ProfeRimoldi/Reloj-Digital-con-ESP32/KiCad/Reloj 3 Placas/.step

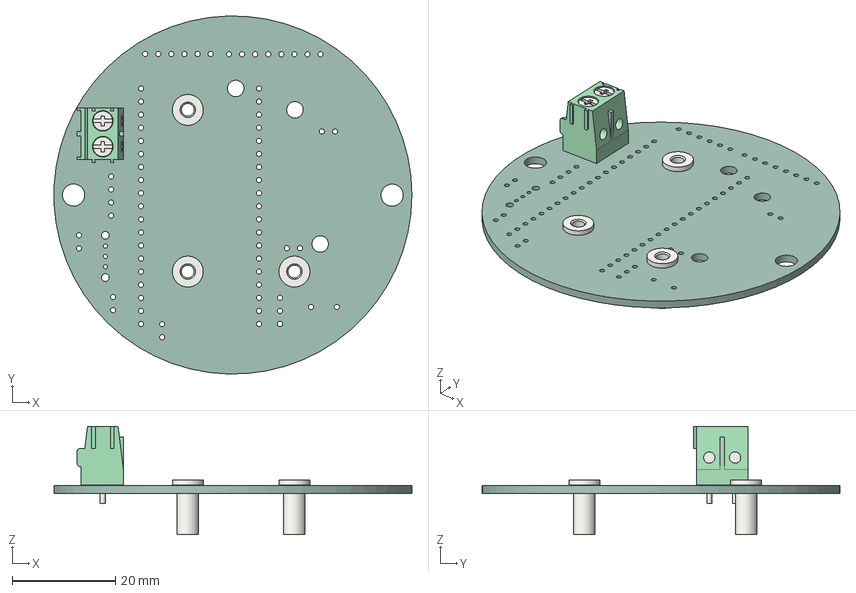
[picture p3: CAD file, 2026-10-23]
KiCad/Reloj 3 Placas/.step
69.5 x 69.5 x 21.0 mm
Mounting_Wuerth_WA-SMSR-M3_H9.6mm_ReverseMount_9775096360 x 3
TerminalBlock_Phoenix_PT-1,5-2-5.0-H_1x02_P5.00mm_Horizontal
OBC_PCB
