ProfeRimoldi/Reloj-Digital-con-ESP32/Outputs/Reloj 3 Placas.pdf

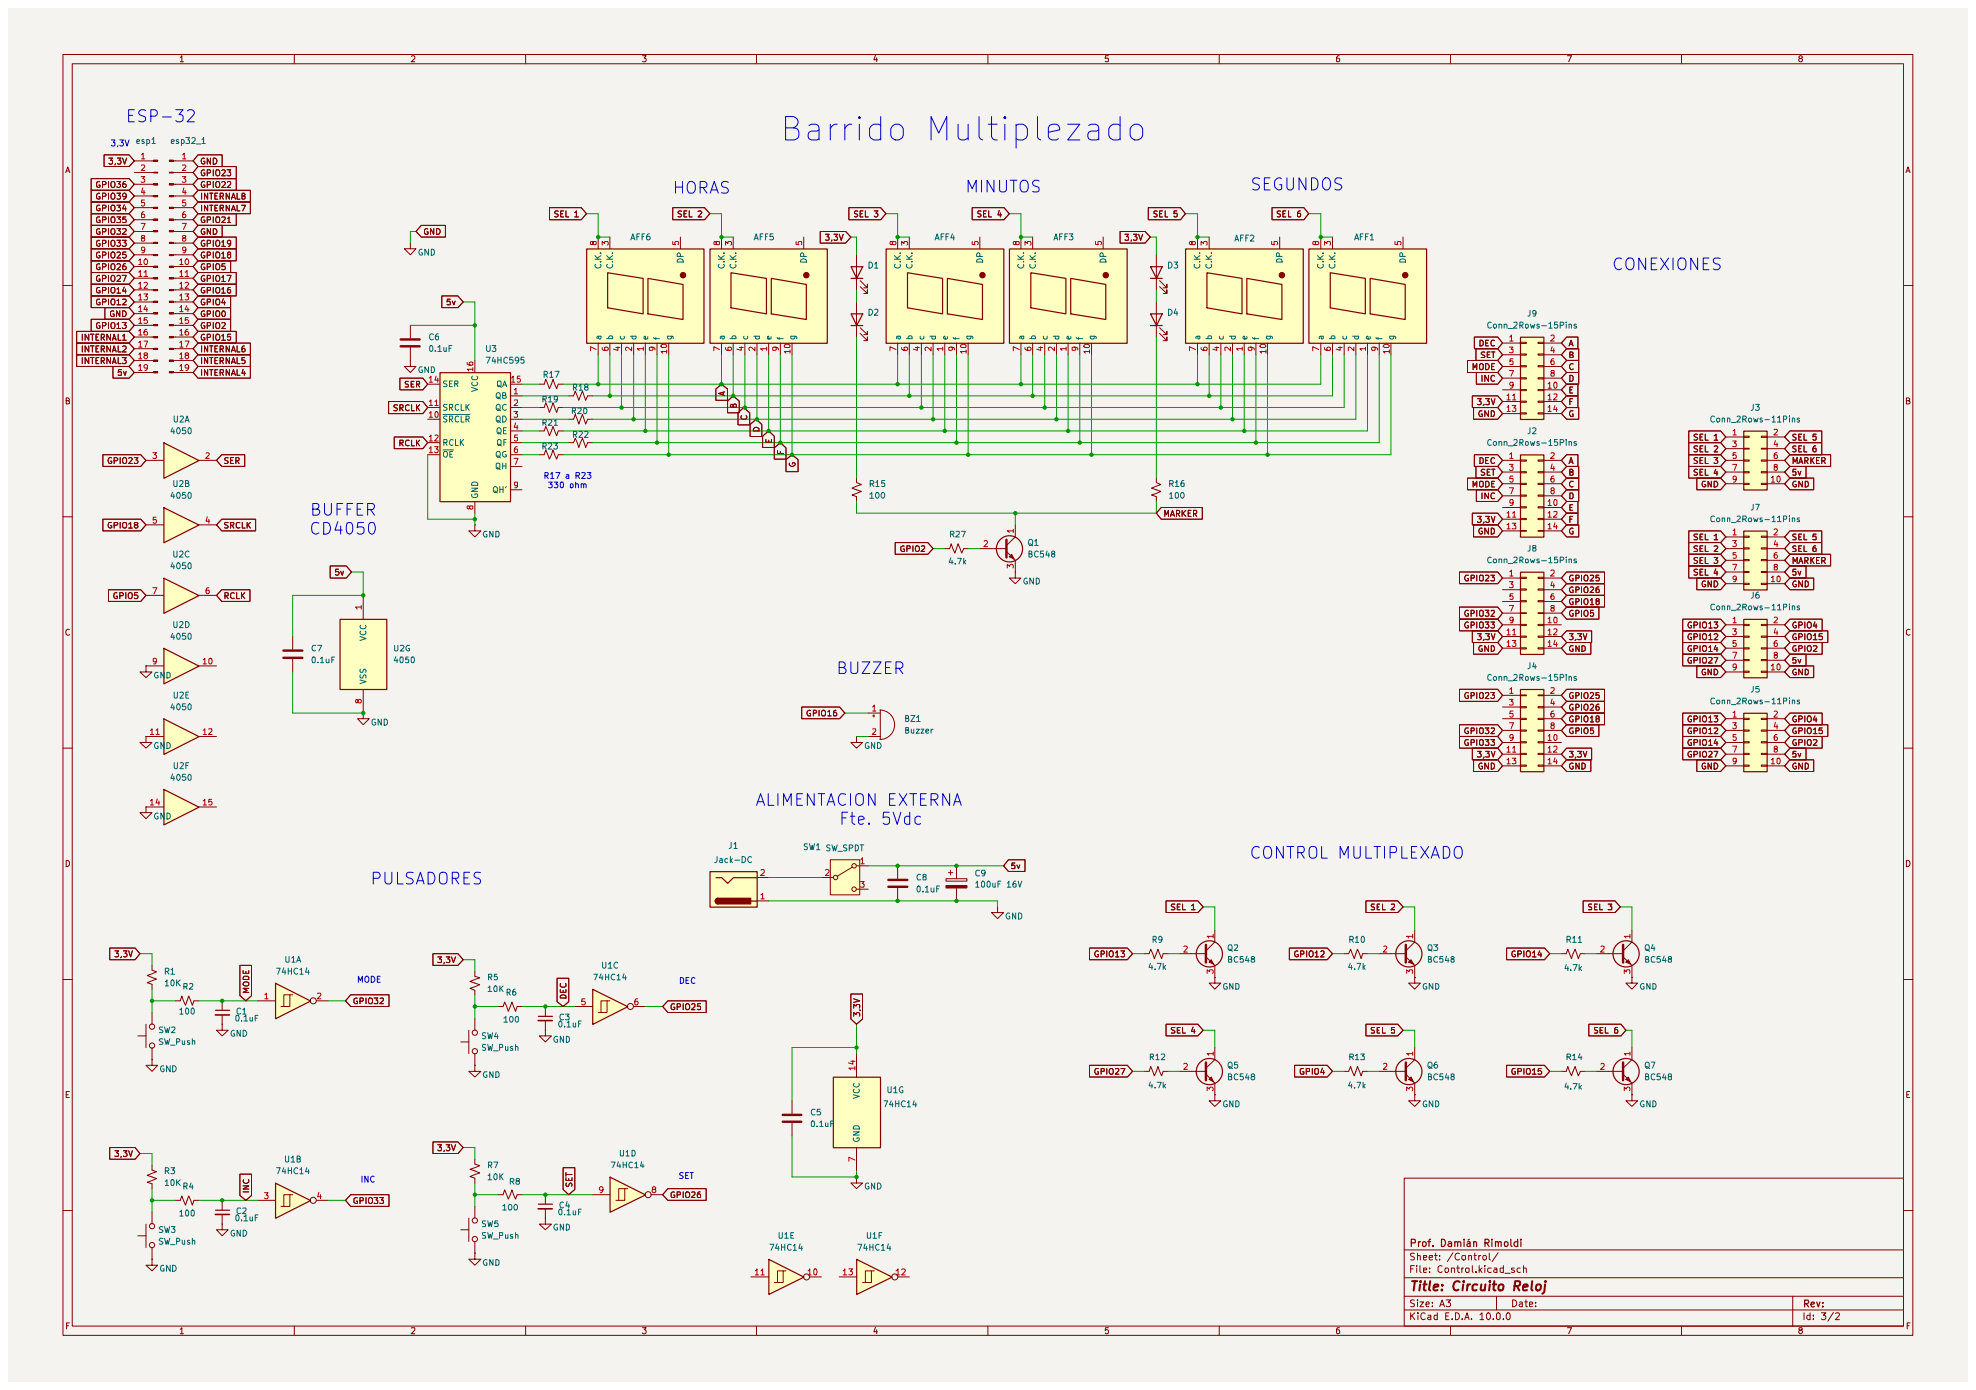
[picture p4: page 1]
