ProfeRimoldi/Reloj-Digital-con-ESP32/Outputs/1 Bcu.pdf

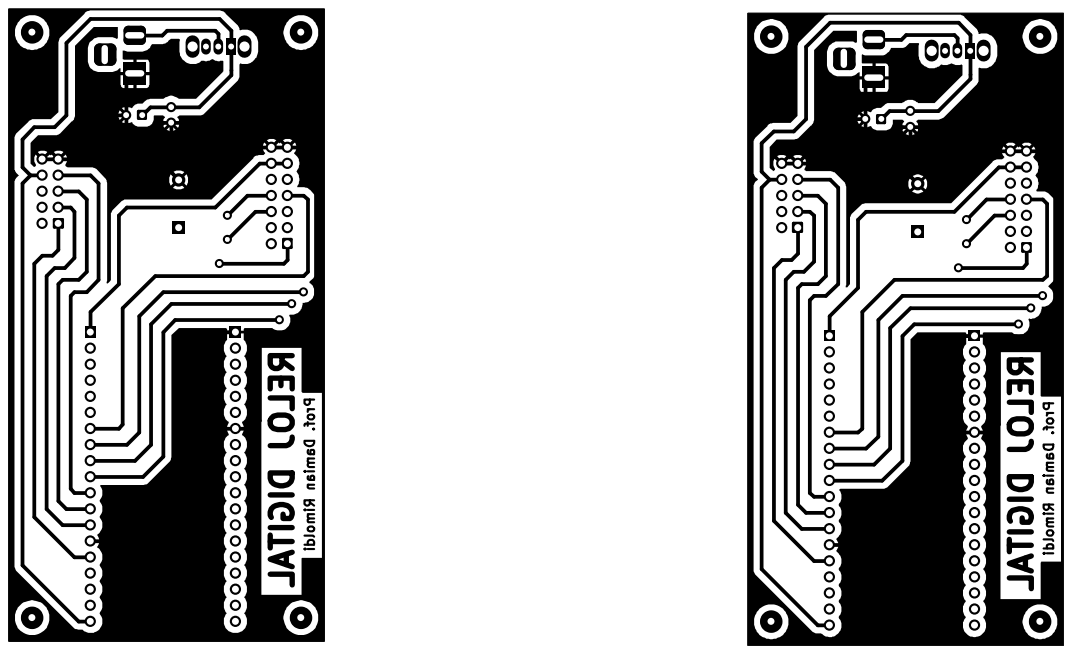
[picture p5: page 1]
