ProfeRimoldi/Reloj-Digital-con-ESP32/Outputs/1 Fcu.pdf

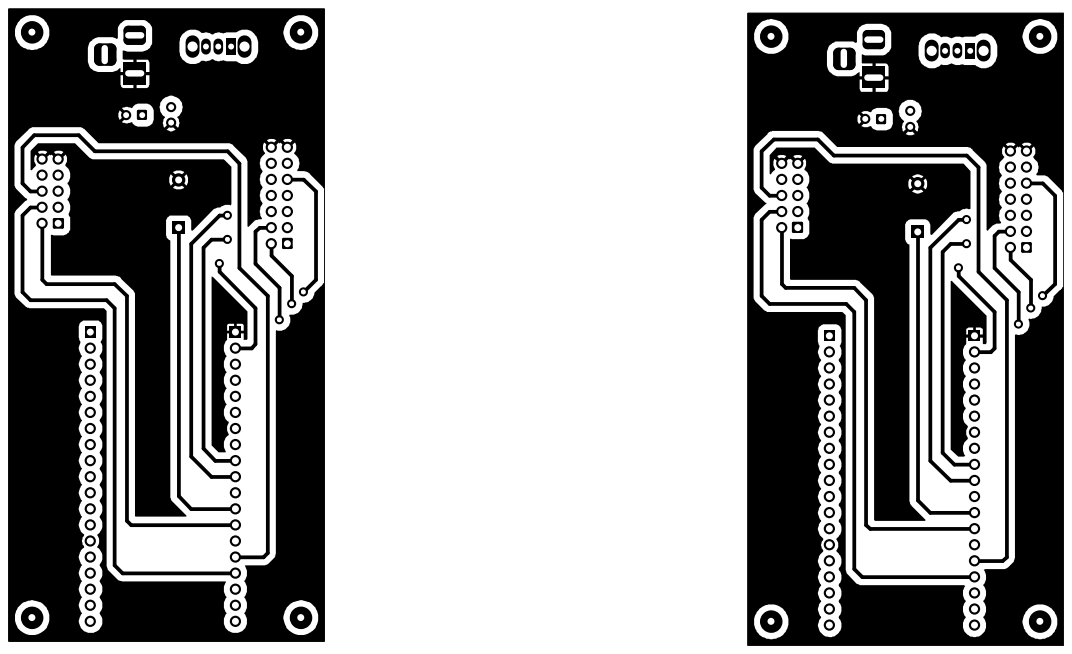
[picture p6: page 1]
