ProfeRimoldi/Reloj-Digital-con-ESP32/Outputs/2 Bcu.pdf

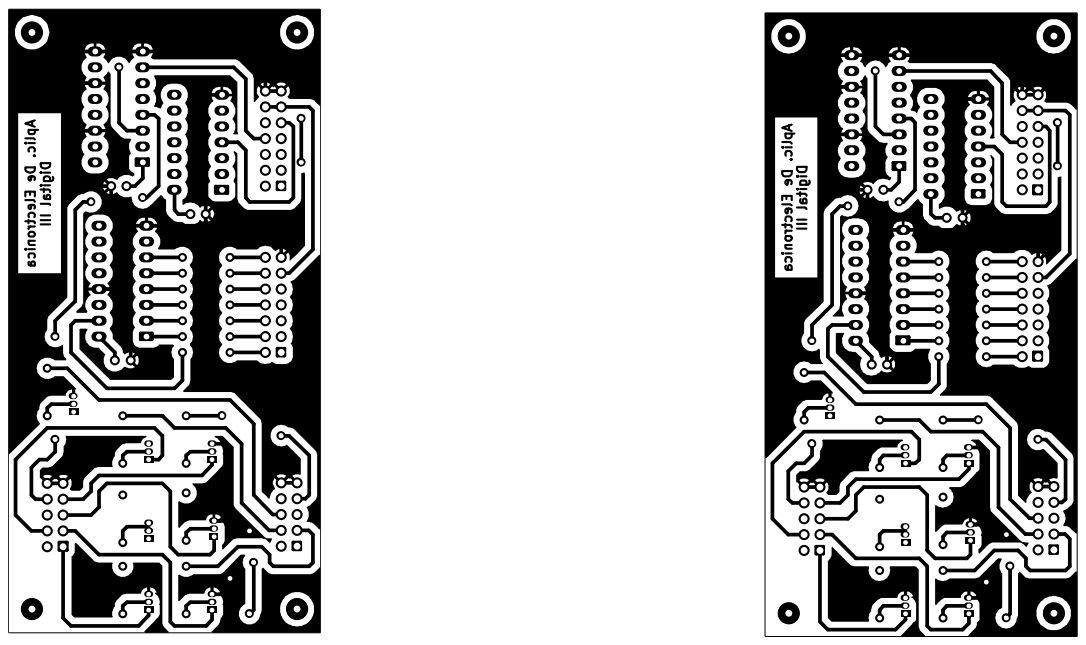
[picture p7: page 1]
