ProfeRimoldi/Reloj-Digital-con-ESP32/Outputs/2 Fcu.pdf

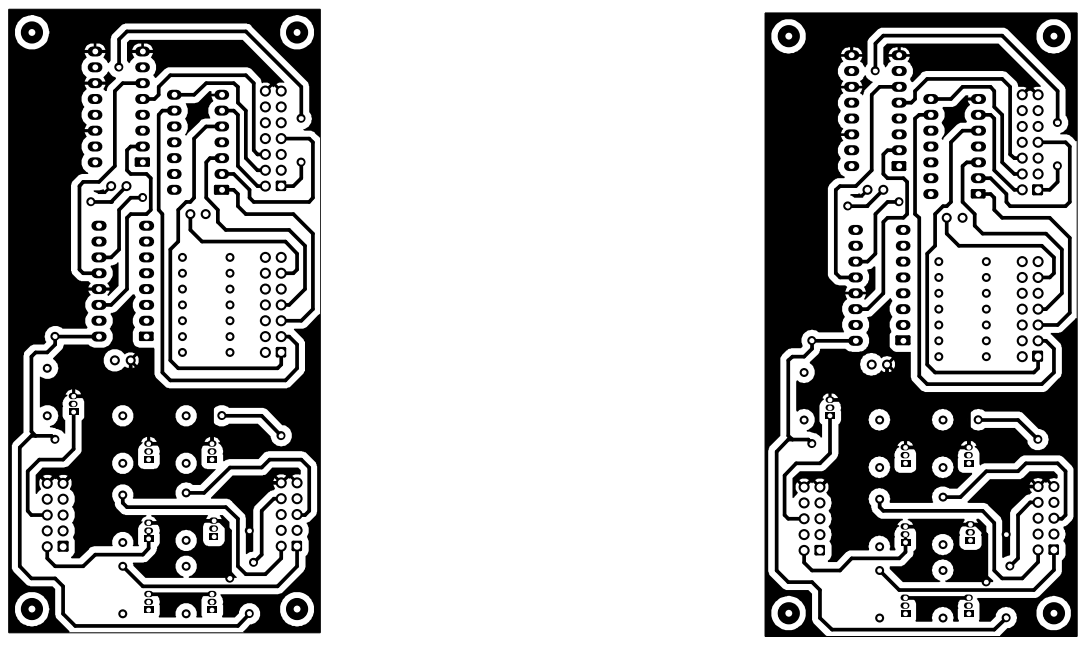
[picture p8: page 1]
