ProfeRimoldi/Reloj-Digital-con-ESP32/Outputs/3 Bcu.pdf

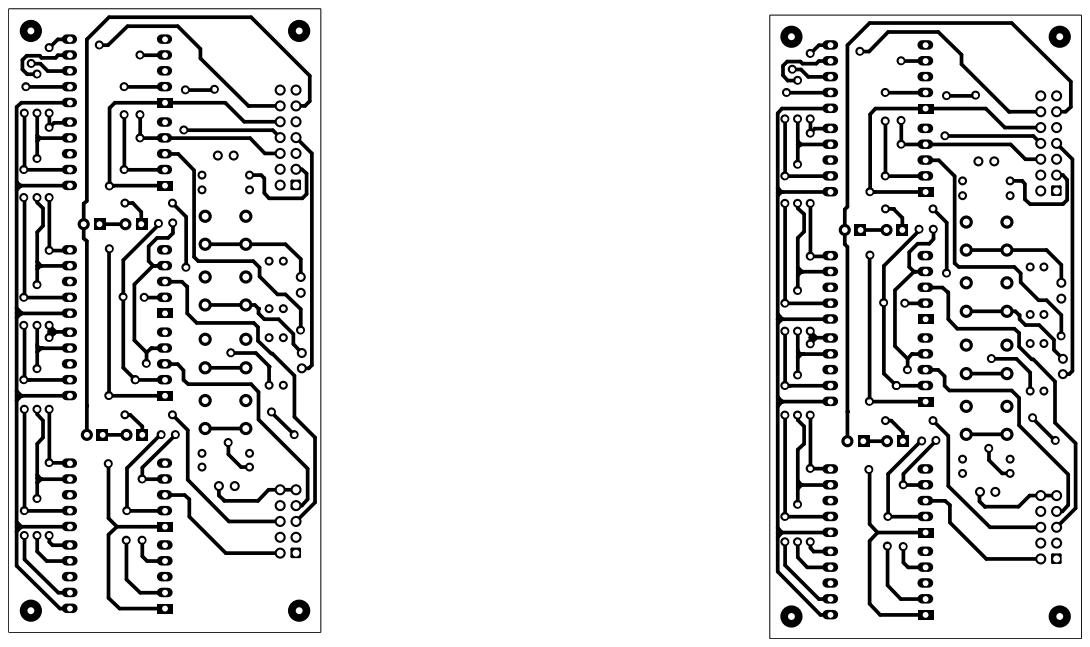
[picture p9: page 1]
