ProfeRimoldi/Reloj-Digital-con-ESP32/Outputs/3 Fcu.pdf

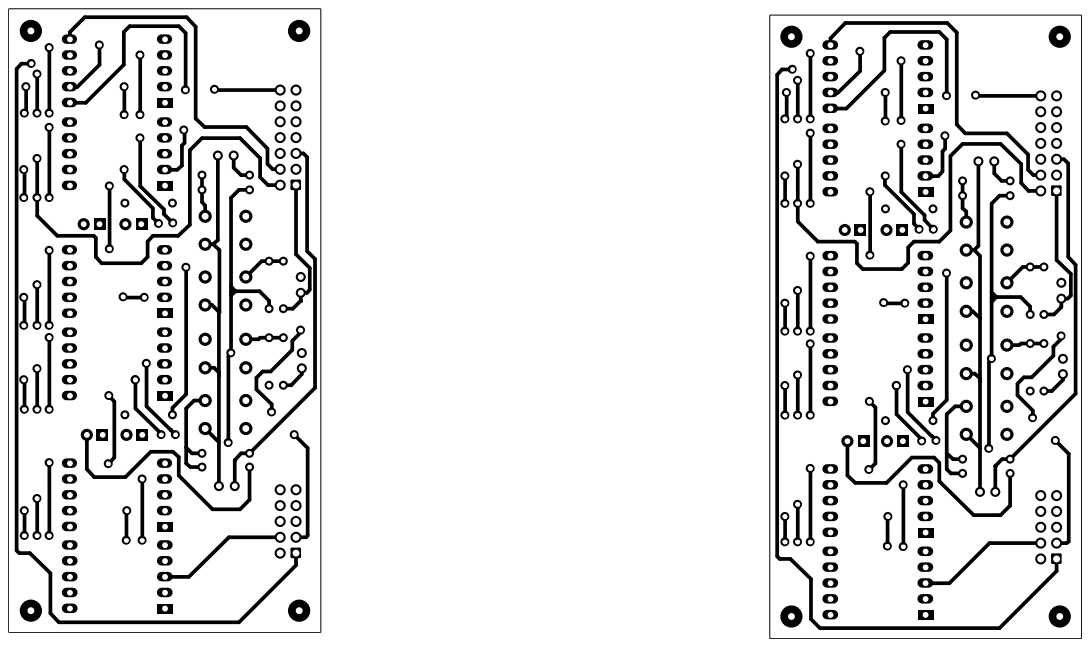
[picture p10: page 1]
