ProfeRimoldi/Reloj-Digital-con-ESP32/KiCad/1.pdf

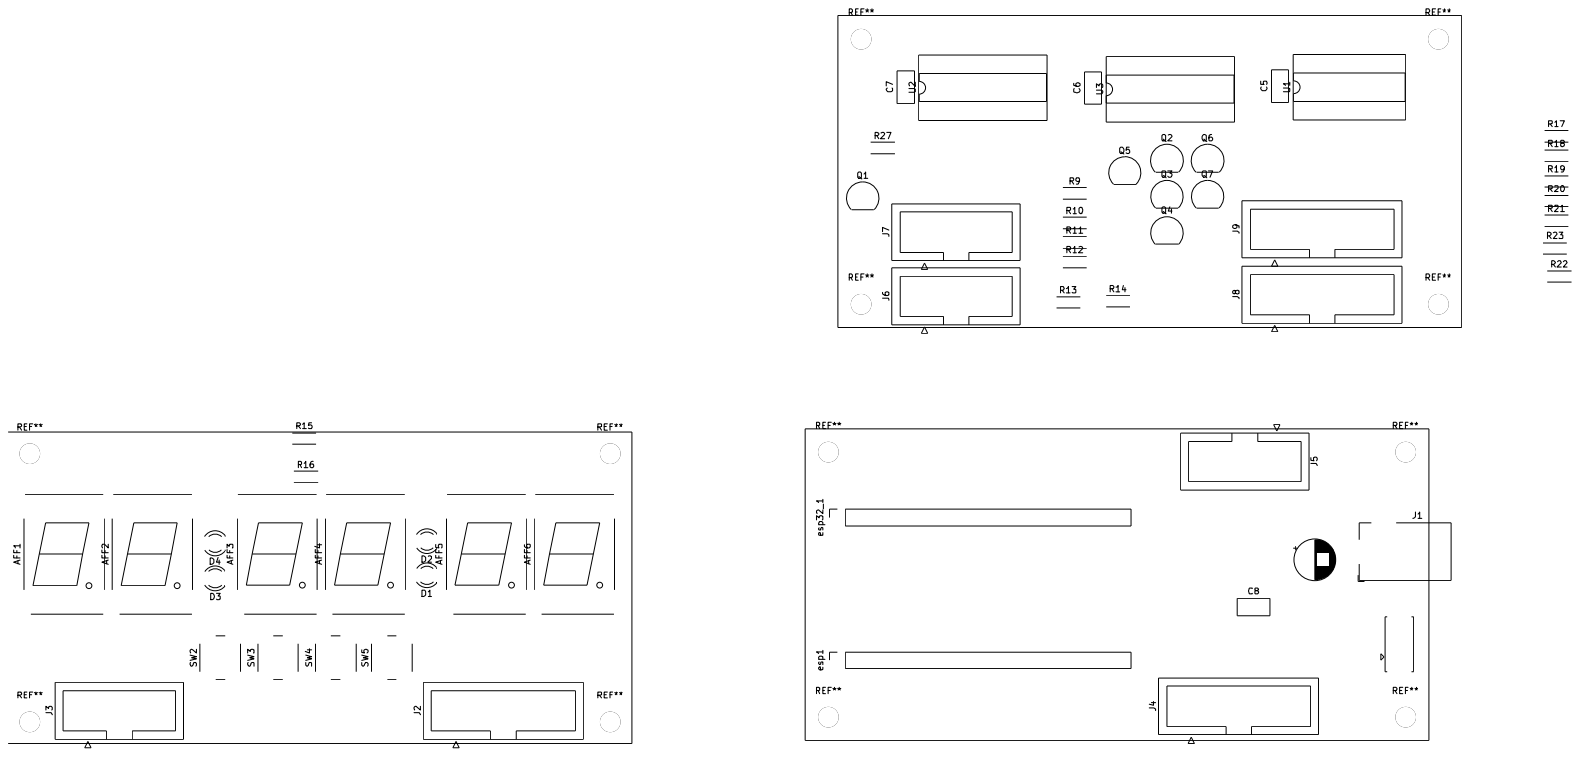
[picture p11: page 1]
