ProfeRimoldi/Reloj-Digital-con-ESP32/KiCad/2.pdf

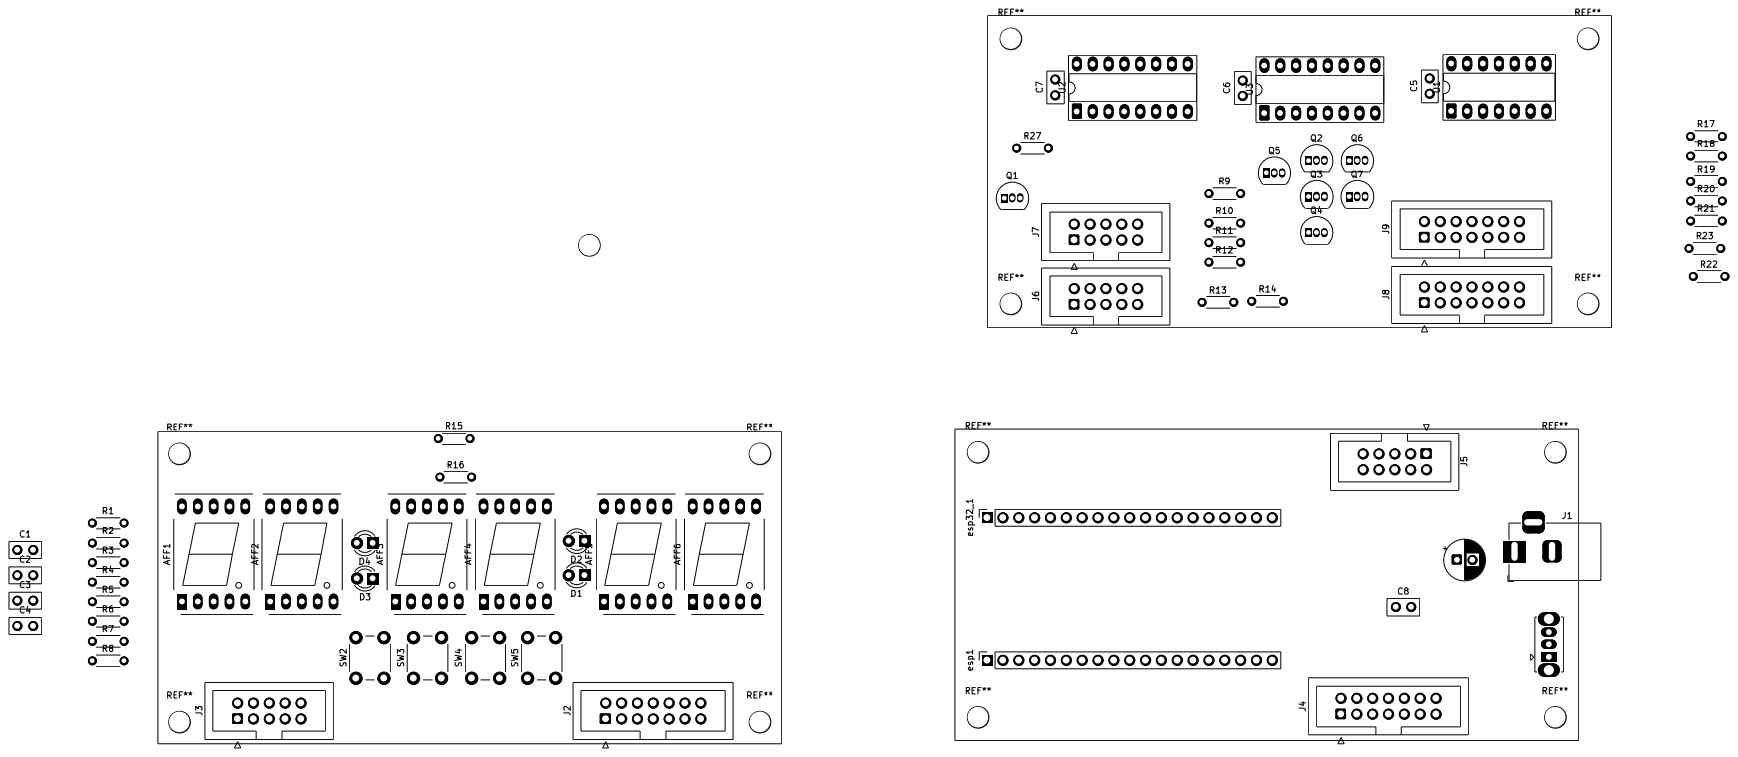
[picture p12: page 1]
