ProfeRimoldi/Reloj-Digital-con-ESP32/Documentacion general/Circuito Reloj con 74HC595.pdf

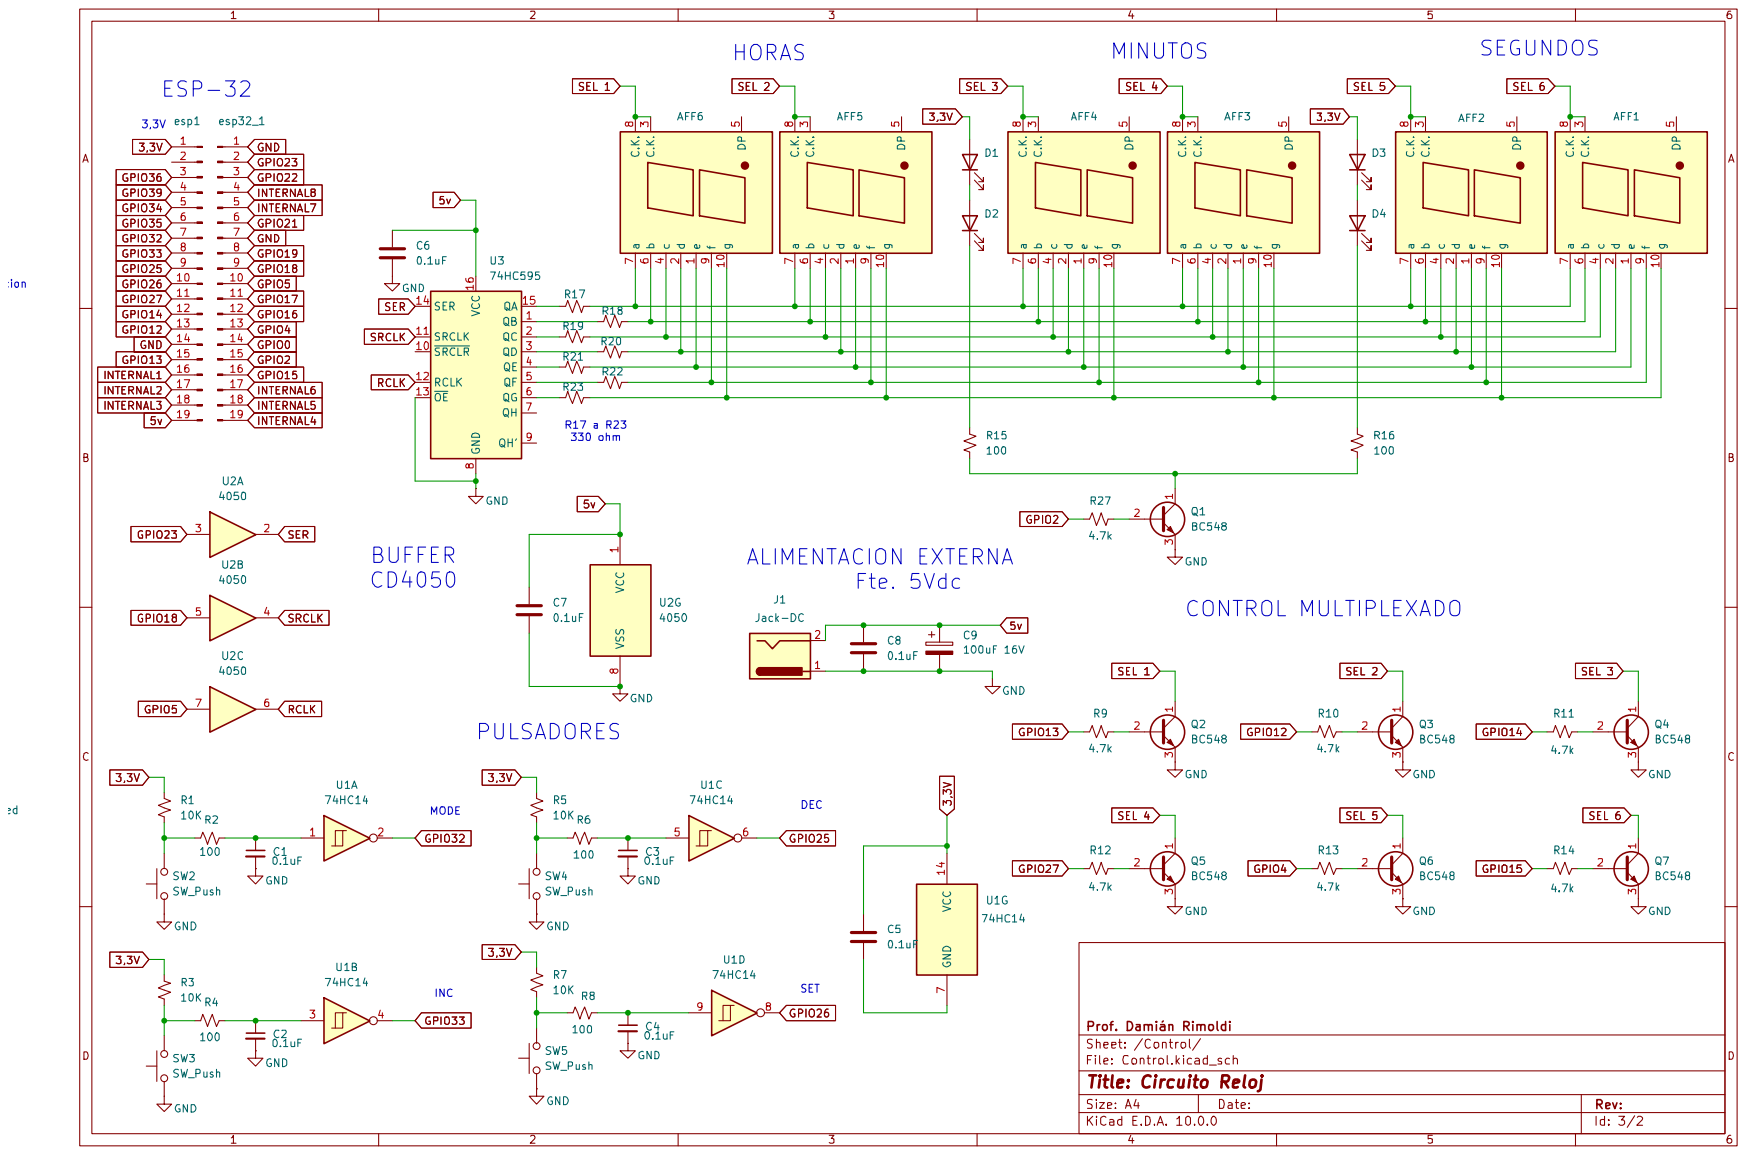
[picture p13: page 1]
