ProfeRimoldi/Reloj-Digital-con-ESP32/Documentacion general/Circuito Reloj.pdf

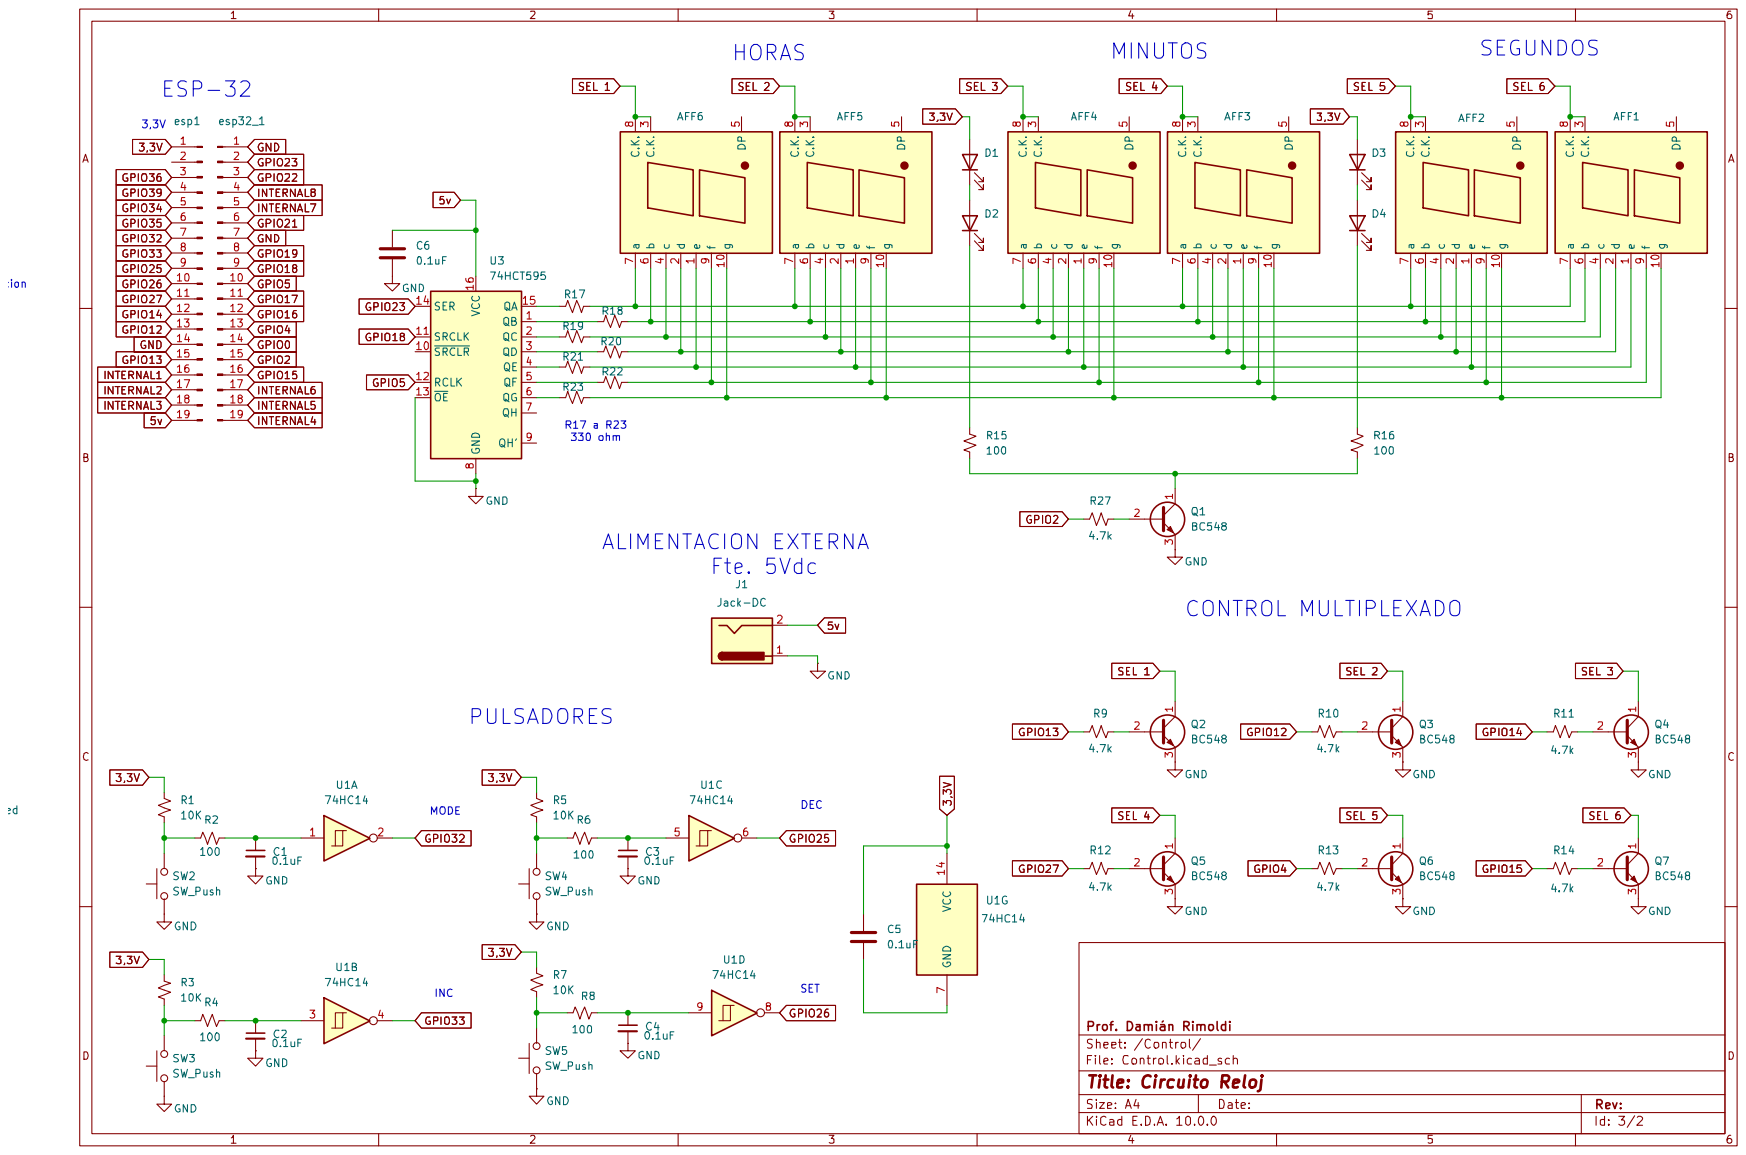
[picture p14: page 1]
