ProfeRimoldi/Reloj-Digital-con-ESP32/Outputs/Fcu/1 Fcu.pdf

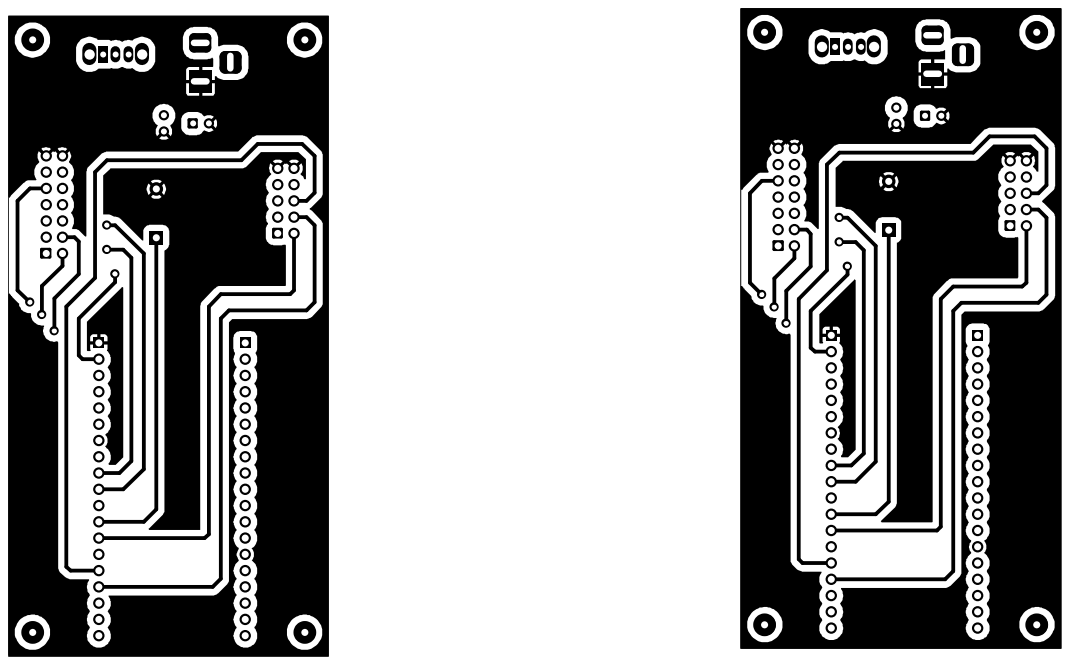
[picture p15: page 1]
