ProfeRimoldi/Reloj-Digital-con-ESP32/Outputs/Fcu/2 Fcu.pdf

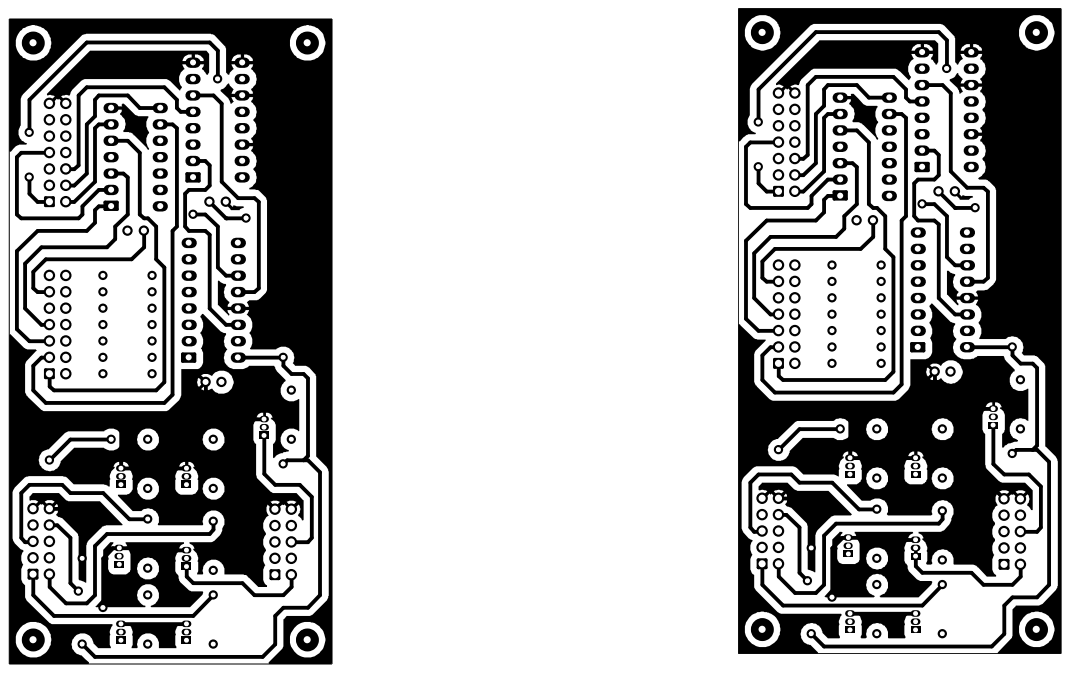
[picture p16: page 1]
