ProfeRimoldi/Reloj-Digital-con-ESP32/Outputs/Fcu/3 Fcu.pdf

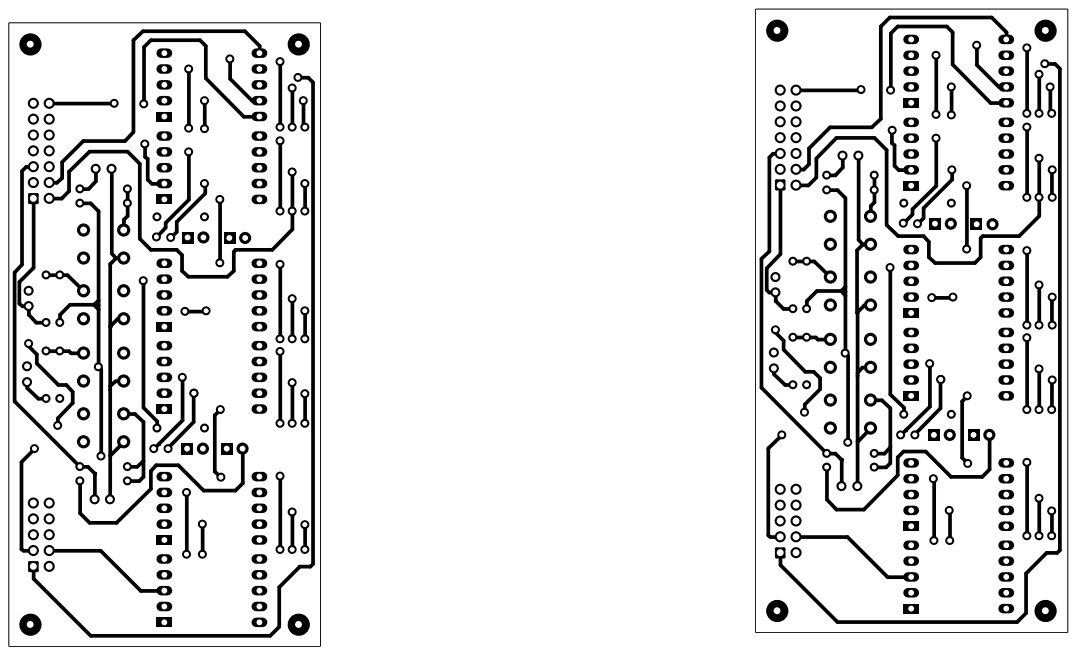
[picture p17: page 1]
