ProfeRimoldi/Reloj-Digital-con-ESP32/KiCad/Reloj/Reloj.kicad_pcb

## KiCad design KiCad/Reloj/Reloj.kicad_pcb (2026-11-04)

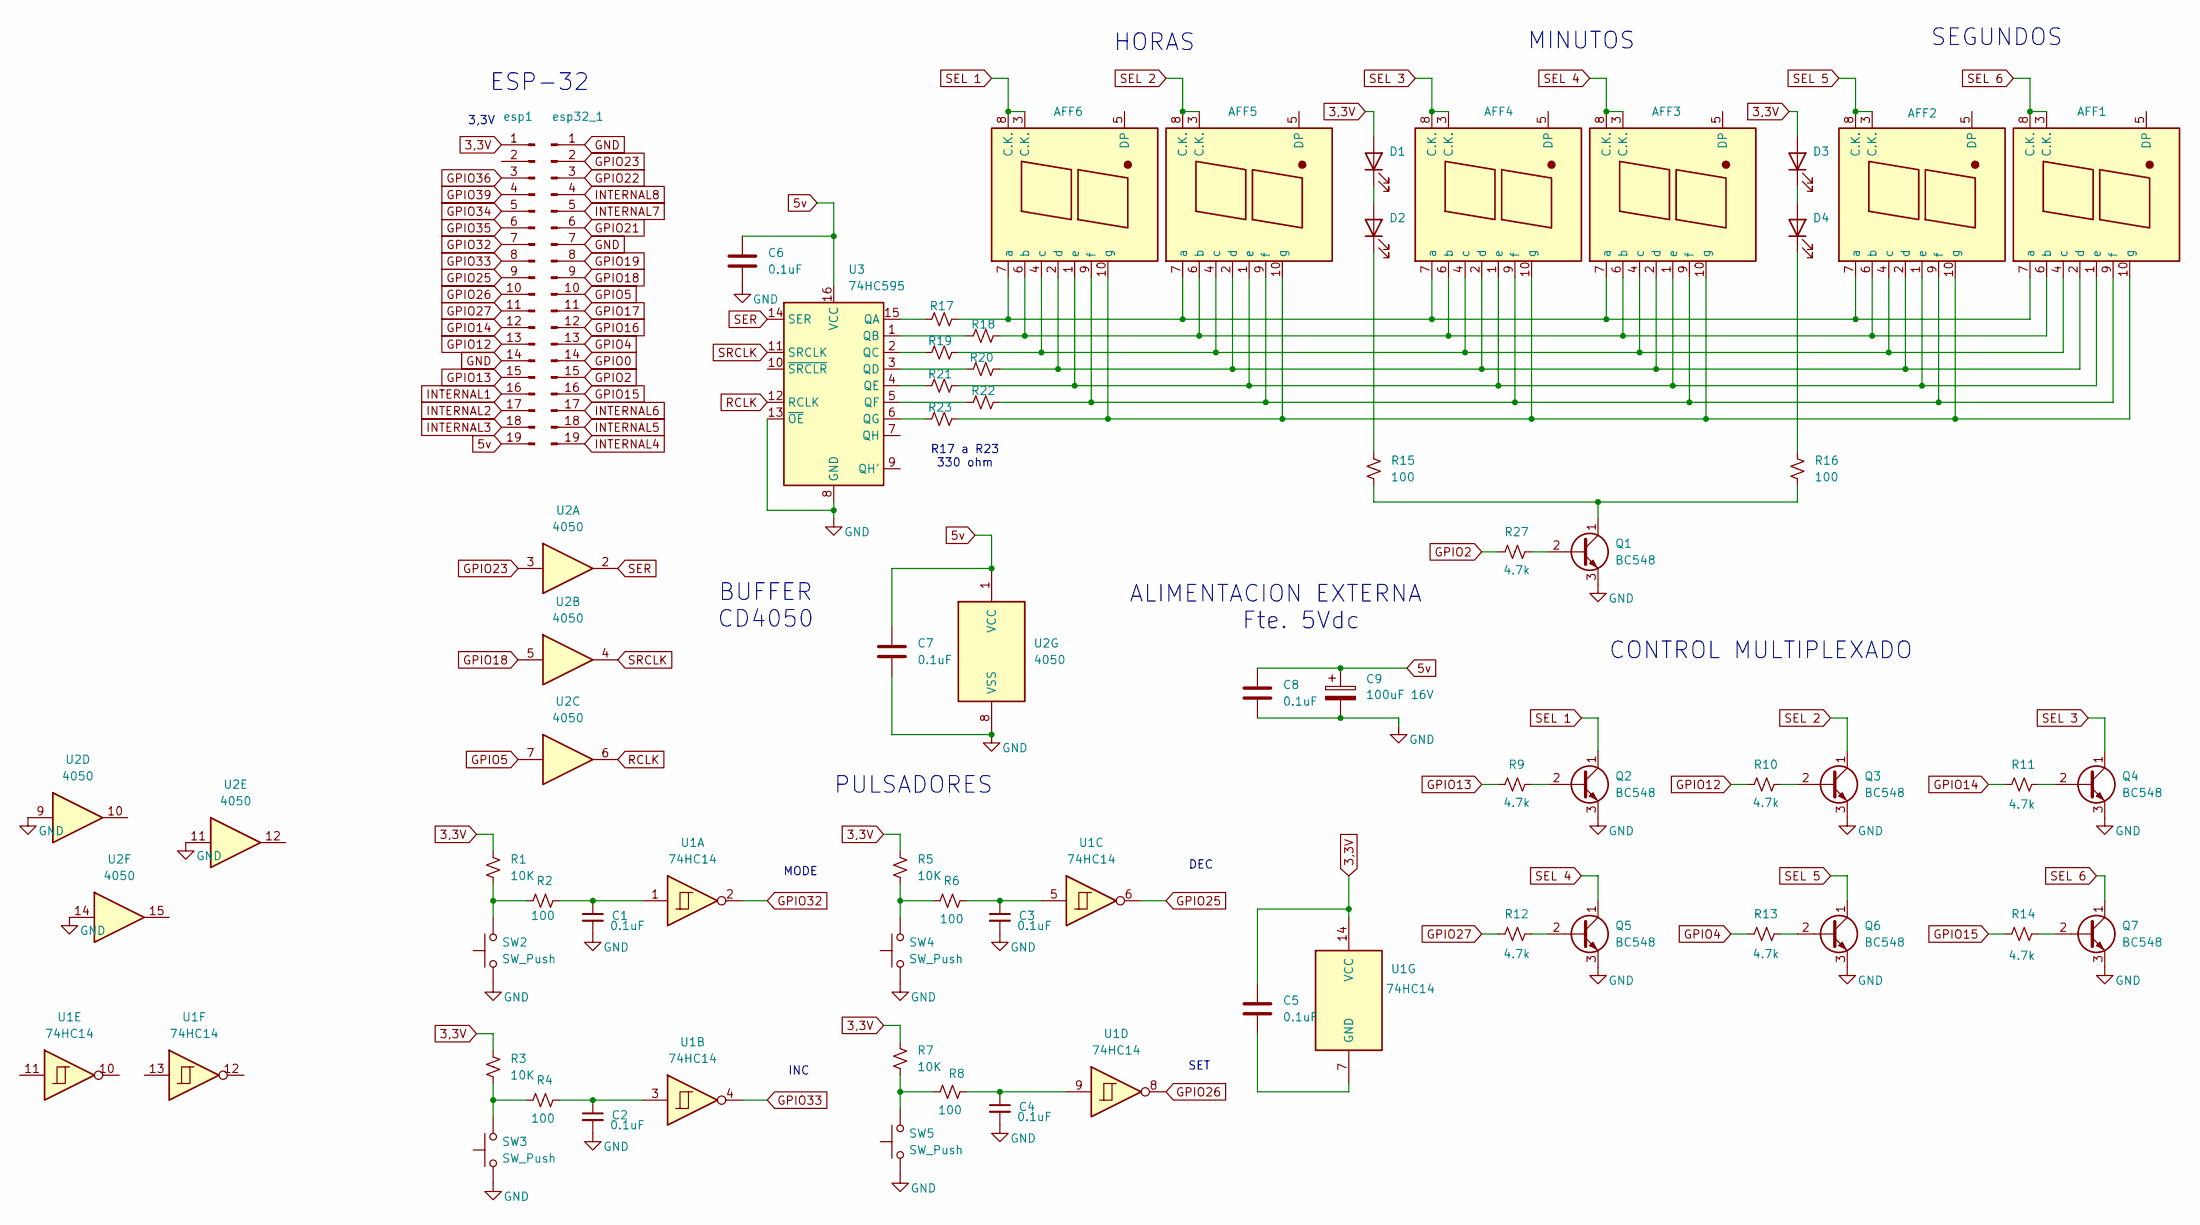
[picture p18: schematic Control.kicad_sch, Circuito Reloj]

Parts:
AFF1, AFF2, AFF3, AFF4, AFF5, AFF6: LTS-6980HR; 7SegmentLED_LTS6760_LTS6780
C1, C2, C3, C4, C5, C6, C7, C8: 0.1uF; C_Disc_D5.0mm_W2.5mm_P2.50mm
C9: 100uF 16V; CP_Radial_D6.3mm_P2.50mm
D1, D2, D3, D4: LED; LED_D3.0mm
Q1, Q2, Q3, Q4, Q5, Q6, Q7: BC548; TO-92_Inline
R1, R3, R5, R7: 10K; R_Axial_DIN0204_L3.6mm_D1.6mm_P5.08mm_Horizontal
R2, R4, R6, R8, R15, R16: 100; R_Axial_DIN0204_L3.6mm_D1.6mm_P5.08mm_Horizontal
R9, R10, R11, R12, R13, R14, R27: 4.7k; R_Axial_DIN0204_L3.6mm_D1.6mm_P5.08mm_Horizontal
R17, R18, R19, R20, R21, R22, R23: 330; R_Axial_DIN0204_L3.6mm_D1.6mm_P5.08mm_Horizontal
SW2, SW3, SW4, SW5: SW_Push; SW_PUSH_6mm_H4.3mm
U1: 74HC14; DIP-14_W7.62mm_Socket_LongPads
U2: 4050; DIP-16_W7.62mm_Socket_LongPads
U3: 74HC595; DIP-16_W7.62mm_Socket_LongPads
esp1, esp32_1: Conn_01x19_Pin; PinSocket_1x19_P2.54mm_Vertical

Connections:
3,3V: C5.1, D1.2 (A), D3.2 (A), R1.1, R3.1, R5.1, R7.1, U1.14 (VCC), esp1.1
5v: C6.1, C7.1, C8.1, C9.1, U2.1 (VCC), U3.16 (VCC), esp1.19
GND: C1.2, C2.2, C3.2, C4.2, C6.2, C7.2, C8.2, C9.2, Q1.3 (E), Q2.3 (E), Q3.3 (E), Q4.3 (E), Q5.3 (E), Q6.3 (E), Q7.3 (E), SW2.1, SW3.1, SW4.1, SW5.1, U2.8 (VSS), U2.9, U2.11, U2.14, U3.8 (GND), U3.13 (~OE), esp1.14, esp32_1.1, esp32_1.7
GPIO0: esp32_1.14
GPIO2: R27.2, esp32_1.15
GPIO4: R13.2, esp32_1.13
GPIO5: U2.7, esp32_1.10
GPIO12: R10.2, esp1.13
GPIO13: R9.2, esp1.15
GPIO14: R11.2, esp1.12
GPIO15: R14.2, esp32_1.16
GPIO16: esp32_1.12
GPIO17: esp32_1.11
GPIO18: U2.5, esp32_1.9
GPIO19: esp32_1.8
GPIO21: esp32_1.6
GPIO22: esp32_1.3
GPIO23: U2.3, esp32_1.2
GPIO25: U1.6, esp1.9
GPIO26: U1.8, esp1.10
GPIO27: R12.2, esp1.11
GPIO32: U1.2, esp1.7
GPIO33: U1.4, esp1.8
GPIO34: esp1.5
GPIO35: esp1.6
GPIO36: esp1.3
GPIO39: esp1.4
INTERNAL1: esp1.16
INTERNAL2: esp1.17
INTERNAL3: esp1.18
INTERNAL4: esp32_1.19
INTERNAL5: esp32_1.18
INTERNAL6: esp32_1.17
INTERNAL7: esp32_1.5
INTERNAL8: esp32_1.4
unnamed: AFF1.7 (a), AFF2.7 (a), AFF3.7 (a), AFF4.7 (a), AFF5.7 (a), AFF6.7 (a), R17.1
unnamed: AFF1.6 (b), AFF2.6 (b), AFF3.6 (b), AFF4.6 (b), AFF5.6 (b), AFF6.6 (b), R18.1
unnamed: AFF1.4 (c), AFF2.4 (c), AFF3.4 (c), AFF4.4 (c), AFF5.4 (c), AFF6.4 (c), R19.1
unnamed: AFF1.2 (d), AFF2.2 (d), AFF3.2 (d), AFF4.2 (d), AFF5.2 (d), AFF6.2 (d), R20.1
unnamed: AFF1.1 (e), AFF2.1 (e), AFF3.1 (e), AFF4.1 (e), AFF5.1 (e), AFF6.1 (e), R21.1
unnamed: AFF1.9 (f), AFF2.9 (f), AFF3.9 (f), AFF4.9 (f), AFF5.9 (f), AFF6.9 (f), R22.1
unnamed: AFF1.10 (g), AFF2.10 (g), AFF3.10 (g), AFF4.10 (g), AFF5.10 (g), AFF6.10 (g), R23.1
unnamed: C1.1, R2.1, U1.1
unnamed: C2.1, R4.1, U1.3
unnamed: C3.1, R6.1, U1.5
unnamed: C4.1, R8.1, U1.9
unnamed: D1.1 (K), D2.2 (A)
unnamed: D2.1 (K), R15.1
unnamed: D3.1 (K), D4.2 (A)
unnamed: D4.1 (K), R16.1
unnamed: Q1.2 (B), R27.1
unnamed: Q1.1 (C), R15.2, R16.2
unnamed: Q2.2 (B), R9.1
unnamed: Q3.2 (B), R10.1
unnamed: Q4.2 (B), R11.1
unnamed: Q5.2 (B), R12.1
unnamed: Q6.2 (B), R13.1
unnamed: Q7.2 (B), R14.1
unnamed: R1.2, R2.2, SW2.2
unnamed: R3.2, R4.2, SW3.2
unnamed: R5.2, R6.2, SW4.2
unnamed: R7.2, R8.2, SW5.2
unnamed: C5.2, U1.7 (GND)
unnamed: R17.2, U3.15 (QA)
unnamed: R18.2, U3.1 (QB)
unnamed: R19.2, U3.2 (QC)
unnamed: R20.2, U3.3 (QD)
unnamed: R21.2, U3.4 (QE)
unnamed: R22.2, U3.5 (QF)
unnamed: R23.2, U3.6 (QG)
RCLK: U2.6, U3.12 (RCLK)
SEL 1: AFF6.3 (C.K.), AFF6.8 (C.K.), Q2.1 (C)
SEL 2: AFF5.3 (C.K.), AFF5.8 (C.K.), Q3.1 (C)
SEL 3: AFF4.3 (C.K.), AFF4.8 (C.K.), Q4.1 (C)
SEL 4: AFF3.3 (C.K.), AFF3.8 (C.K.), Q5.1 (C)
SEL 5: AFF2.3 (C.K.), AFF2.8 (C.K.), Q6.1 (C)
SEL 6: AFF1.3 (C.K.), AFF1.8 (C.K.), Q7.1 (C)
SER: U2.2, U3.14 (SER)
SRCLK: U2.4, U3.11 (SRCLK)

Notes on the sheet:
HORAS
SET
SEGUNDOS
3,3V
R17 a R23 330 ohm
PULSADORES
DEC
MINUTOS
ALIMENTACION EXTERNA Fte. 5Vdc
CONTROL MULTIPLEXADO
INC
BUFFER CD4050
MODE
ESP-32

Board: 2 copper layers, 59 parts (0 on the bottom side), 61 nets, no tracks yet.
