ProfeRimoldi/Reloj-Digital-con-ESP32/(commit log)

2026-10-23 Commit inicial: esquematico y arquitectura general
    [.step, Control.kicad_sch, Reloj.kicad_pcb, Reloj.kicad_sch]
2026-10-23 Organización de archivos, adición de README y configuración de gitignore
2026-10-25 Actualizo circuito y defino alimentaciones
    [Control.kicad_sch]
2026-10-25 Agrego nueva numeracion de componentes e impresion de pdf
    [Control.kicad_sch]
2026-10-26 Modifico circuito implementando CD4050
    [Control.kicad_sch]
2026-10-27 Selecciono footprints y disposicion prelimar de PCB
    [Control.kicad_sch, Reloj.kicad_pcb, Reloj.kicad_sch]
2026-10-27 Agrego version 3 placas, distribucion principal y conectores
    [.step, Control.kicad_sch, Reloj 3 Placas.kicad_pcb, Reloj 3 Placas.kicad_sch, Reloj.kicad_pcb]
2026-10-29 Cambio footprint Resistencias y primer ruteo de Displays
    [Control.kicad_sch, Reloj 3 Placas.kicad_pcb]
2026-10-30 End design of Display Board.
    [Reloj 3 Placas.kicad_pcb]
2026-10-31 Hago los 3 PCB e imprimo pdf en la carpeta OUTPUT
    [Control.kicad_sch, Reloj 3 Placas.kicad_pcb]
2026-11-04 PCB final design and add some outputs
    [Control.kicad_sch, Reloj 3 Placas.kicad_pcb]
2026-11-04 preparo archivo para desarrollo nuevo
    [Control.kicad_sch, Reloj.kicad_pcb]
